t3rwin/2-channel-EEG/KiCad/2-channel-EEG.kicad_pcb

## KiCad design KiCad/2-channel-EEG.kicad_pcb (2024-04-19)

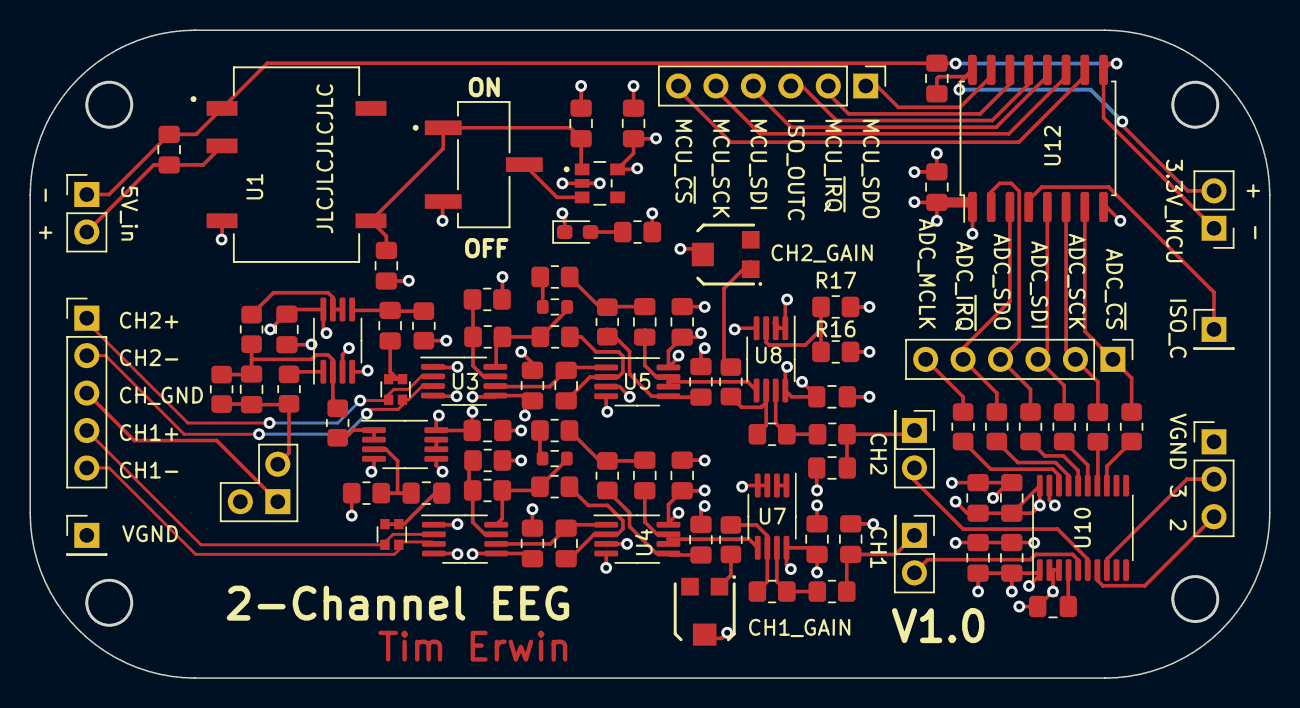
[picture p1: board 2-channel-EEG.kicad_pcb from above]

Board: 4 copper layers, 84.1 x 43.9 mm, 92 parts (0 on the bottom side), 74 nets.

Parts:
C1: 4.7u; C_0805_2012Metric_Pad1.18x1.45mm_HandSolder
C2, C3, C7, C8, C9, C10, C11, C15, C18, C21, C23, C24, C26, C27, C30: 0.1u; C_0805_2012Metric_Pad1.18x1.45mm_HandSolder
C4, C5, C6, C16, C17, C19, C20, C25: 10u; C_0805_2012Metric_Pad1.18x1.45mm_HandSolder
C12, C28, C29: 1u; C_0805_2012Metric_Pad1.18x1.45mm_HandSolder
C13, C14: 47n; C_0805_2012Metric_Pad1.18x1.45mm_HandSolder
C22: 1n; C_0805_2012Metric_Pad1.18x1.45mm_HandSolder
D1: LED_0603_1608Metric_Pad1.05x0.95mm_HandSolder
J1: Power_Input; PinHeader_1x02_P2.54mm_Vertical
J2: Nucleo_3.3; PinHeader_1x02_P2.54mm_Vertical
J3: Electrode_Input; PinHeader_1x05_P2.54mm_Vertical
J4: GND_select; PinHeader_2x02_P2.54mm_Vertical
J5, J6: Conn_02x01; PinHeader_2x01_P2.54mm_Vertical
J7: VGND; PinHeader_1x01_P2.54mm_Vertical
J8: Conn_01x03; PinHeader_1x03_P2.54mm_Vertical
J9: ADC_Data; PinHeader_1x06_P2.54mm_Vertical
J10: ISO_IN_C; PinHeader_1x01_P2.54mm_Vertical
J11: MCU_Data; PinHeader_1x06_P2.54mm_Vertical
JP1, JP2: SolderJumper_2_Open; R_0603_1608Metric
R1, R3, R21, R30, R31: 1M; R_0805_2012Metric_Pad1.20x1.40mm_HandSolder
R2, R4: 1K; R_0805_2012Metric_Pad1.20x1.40mm_HandSolder
R5, R6: 3M; R_0805_2012Metric_Pad1.20x1.40mm_HandSolder
R7, R8, R9, R10: 56.2k; R_0805_2012Metric_Pad1.20x1.40mm_HandSolder
R11: 510; R_0805_2012Metric_Pad1.20x1.40mm_HandSolder
R12, R13: 1k; R_0805_2012Metric_Pad1.20x1.40mm_HandSolder
R14, R15: 100k; R_0805_2012Metric_Pad1.20x1.40mm_HandSolder
R16, R17, R22, R23: 10k; R_0805_2012Metric_Pad1.20x1.40mm_HandSolder
R18, R19: 100; R_0805_2012Metric_Pad1.20x1.40mm_HandSolder
R20: 0; R_0805_2012Metric_Pad1.20x1.40mm_HandSolder
R24, R25, R26, R27, R28, R29: 10; R_0805_2012Metric_Pad1.20x1.40mm_HandSolder
RN1, RN2: Matched_10K_Resistor_Array_2x; R_Array_Matched_2x0606
RV1, RV2: 10k; TRIM_35WR10KLFTR
SW1: SW_Push_SPDT; SW_JS102011SCQN
U1: PESE1-S5-S5-M-TR; CONV_PESE1-S5-S5-M
U2, U3: AD8237; MSOP-8_3x3mm_P0.65mm
U4, U5, U7, U8, U9, U11: AD8606; MSOP-8_3x3mm_P0.65mm
U6: TCR2EF33; IC_TC4S584F_LF
U10: MCP3562R; TSSOP-20_4.4x6.5mm_P0.65mm
U12: ISO6763-Q1; SOIC-16W_7.5x10.3mm_P1.27mm

Connections:
+3.3V: C2.2, C3.2, C7.2, C8.2, C12.2, C15.1, C18.1, C20.2, C21.2, C23.2, C24.2, C25.2, C26.2, C27.1, R11.2, R16.2, U2.5 (V+), U3.5 (V+), U4.8 (V+), U5.8 (V+), U6.5 (VOUT), U7.8 (V+), U8.8 (V+), U9.8 (V+), U10.1 (AVDD), U10.20 (DVDD), U11.8 (V+), U12.1 (VCC1)
+3V3_nucleo: C30.1, J2.1, U12.16 (VCC2)
+5V: C1.2, J1.1, U1.2 (+VIN)
+5V_iso: C4.2, C9.2, SW1.1 (A), U1.5 (+VOUT), U6.1 (VIN)
/ADC0: J5.2, U10.5 (CH0)
/ADC1: J6.2, U10.6 (CH1)
/ADC2: J8.3, U10.7 (CH2)
/ADC3: J8.2, U10.8 (CH3)
/ADC_MCLK: J9.6, R24.1
/ADC_SCK: J9.2, R28.1, U12.6 (OUTE)
/ADC_SDI: J9.3, R27.1, U12.5 (OUTD)
/ADC_SDO: J9.4, R26.1, U12.2 (INA)
/ADC_~CS: J9.1, R29.1, U12.7 (OUTF)
/ADC_~IRQ: J9.5, R25.1, U12.3 (INB)
/CH1+: J3.4, RN2.3, U2.2 (+)
/CH1-: J3.5, RN2.4, U2.3 (-)
/CH1_AO: C16.2, J5.1, R18.1
/CH2+: J3.1, RN1.3, U3.2 (+)
/CH2-: J3.2, RN1.4, U3.3 (-)
/CH2_AO: C17.2, J6.1, R19.1
/CH_GND: J3.3, J4.1
/Driven_GND: C22.1, J4.2, R20.1, R21.1
/ISO_INC: J10.1, U12.4 (INC)
/ISO_OUTC: J11.3, U12.13 (OUTC)
/LDO_CTRL: SW1.2 (B), U6.3 (CTRL)
/MCU_SCK: J11.5, U12.11 (INE)
/MCU_SDI: J11.4, U12.12 (IND)
/MCU_SDO: J11.1, U12.15 (OUTA)
/MCU_~CS: J11.6, U12.10 (INF)
/MCU_~IRQ: J11.2, U12.14 (OUTB)
/VGND: C13.1, C14.1, C16.1, C17.1, J4.3 (Pin_4), J7.1, J8.1, R2.2, R4.2, R30.1, R31.1, RV1.2, RV2.2, U4.3 (+), U5.3 (+), U8.1, U8.2 (-), U9.3 (+)
GND: C2.1, C3.1, C4.1, C7.1, C8.1, C9.1, C12.1, C15.2, C18.2, C19.2, C20.1, C21.1, C23.1, C24.1, C25.1, C26.1, C27.2, D1.1 (K), R17.1, SW1.3 (C), U1.4 (0V), U2.1 (BW), U2.4 (V-), U3.1 (BW), U3.4 (V-), U4.4 (V-), U5.4 (V-), U6.2 (GND), U7.3 (+), U7.4 (V-), U8.4 (V-), U9.4 (V-), U10.2 (AGND), U10.3 (REFIN-), U10.19 (DGND), U11.4 (V-), U11.5 (+), U12.8 (GND1)
GND1: C1.1, C30.2, J1.2, J2.2, U1.1 (GND), U12.9 (GND2)
unnamed: C10.1, R7.1, R9.2
unnamed: C11.1, R8.1, R10.2
unnamed: C28.2, RN1.1, RN1.2
unnamed: C29.2, RN2.1, RN2.2
unnamed: D1.2 (A), R11.1
unnamed: JP1.1 (A), R1.1, R5.2, U2.8
unnamed: JP1.2 (B), R7.2
unnamed: JP2.1 (A), R3.1, R6.2, U3.8
unnamed: JP2.2 (B), R8.2
unnamed: R12.1, RV1.1
unnamed: R13.1, RV2.1
unnamed: R14.2, R18.2, U7.7
unnamed: R15.2, R19.2, U8.7
unnamed: R20.2, U9.1
unnamed: R1.2, R2.1, U2.7 (FB)
unnamed: C5.1, U2.6 (VREF), U4.1
unnamed: R3.2, R4.1, U3.7 (FB)
unnamed: C6.1, U3.6 (VREF), U5.1
unnamed: C5.2, R5.1, U4.2 (-)
unnamed: C13.2, R9.1, U4.5 (+)
unnamed: C10.2, U4.6 (-), U4.7, U7.5 (+)
unnamed: C6.2, R6.1, U5.2 (-)
unnamed: C14.2, R10.1, U5.5 (+)
unnamed: C11.2, U5.6 (-), U5.7, U8.5 (+)
unnamed: U7.1, U7.2 (-)
unnamed: R12.2, R14.1, U7.6 (-)
unnamed: R16.1, R17.2, U8.3 (+)
unnamed: R13.2, R15.1, U8.6 (-)
unnamed: C22.2, R21.2, R22.2, R23.1, U9.2 (-)
unnamed: C28.1, R30.2, U9.5 (+)
unnamed: R22.1, U9.6 (-), U9.7
unnamed: R24.2, U10.18 (MCLK)
unnamed: C19.1, U10.4 (REFIN+/OUT)
unnamed: R28.2, U10.14 (SCK)
unnamed: R27.2, U10.15 (SDI)
unnamed: R26.2, U10.16 (SDO)
unnamed: R29.2, U10.13 (~CS)
unnamed: R25.2, U10.17 (~IRQ/MDAT)
unnamed: C29.1, R31.2, U11.3 (+)
unnamed: R23.2, U11.1, U11.2 (-)
unnamed: U11.6 (-), U11.7
