t3rwin/2-channel-EEG/py/Arduino_Com.py

import serial.tools.list_ports

ports = serial.tools.list_ports.comports()
serialInst = serial.Serial()

portsList = []

for onePort in ports:
    portsList.append(str(onePort))
    print(str(onePort))

val = input("Select Port: COM")

for x in range(0,len(portsList)):
    if portsList[x].startswith("COM" + str(val)):
        portVar = "COM" + str(val)
        print(portVar)

serialInst.baudrate = 11600
serialInst.port = portVar
serialInst.open()

while True:
	if serialInst.in_waiting:
		packet = serialInst.readline()
		print(packet.decode('utf').rstrip('\n'))
