t3rwin/2-channel-EEG/(commit log)

2024-01-16 Schematic Updates
    isolation converter, 3.3V LDO, Channel1, Driven GND, Rail Splitter
    [2-channel-EEG.kicad_sch]
2024-01-18 separated kicad files from python files
    [2-channel-EEG.kicad_pcb, 2-channel-EEG.kicad_sch]
2024-02-05 fixed power connections on U3A, added output filter
    [2-channel-EEG.kicad_sch]
2024-04-02 add 2nd channel, start pcb
    [2-channel-EEG.kicad_pcb, 2-channel-EEG.kicad_sch]
2024-04-03 PCB updates
    [2-channel-EEG.kicad_pcb]
2024-04-04 drl filter, additional caps for adc, Rs for adc spi.
    [2-channel-EEG.kicad_pcb, 2-channel-EEG.kicad_sch]
2024-04-05 updated DRL and pcb
    [2-channel-EEG.kicad_pcb, 2-channel-EEG.kicad_sch]
2024-04-08 added solder jumpers between INA and filter
    [2-channel-EEG.kicad_pcb, 2-channel-EEG.kicad_sch]
2024-04-09 fix wrong reference C,R values
    [2-channel-EEG.kicad_pcb, 2-channel-EEG.kicad_sch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]
2024-04-10 schematic BOM
    [2-channel-EEG.csv, 2-channel-EEG.kicad_pcb, 2-channel-EEG.kicad_sch, BOM_2-channel-EEG.csv]
2024-04-12 final edits before ordering PCB
    [2-channel-EEG-B_Cu.gbl, 2-channel-EEG-B_Mask.gbs, 2-channel-EEG-B_Paste.gbp, 2-channel-EEG-B_Silkscreen.gbo, 2-channel-EEG-Edge_Cuts.gm1, 2-channel-EEG-F_Cu.gtl, 2-channel-EEG-F_Mask.gts, 2-channel-EEG-F_Paste.gtp]
2024-04-15 py live processing
    live filtering and plotting of pre recorded data
2024-04-17 Create UART
2024-04-17 live processing update
    [power.csv]
2024-04-17 Main and it's prototypes
2024-04-19 fixed missaligned input labels :(
    [2-channel-EEG.kicad_pcb]
2024-04-23 File contains code that is sent via uart
    receiving the data with minimal processing
2024-04-25 upsampling and interpolation of power values
2024-04-25 edit .gitignore
    [BOM_2-channel-EEG copy.csv]
2024-05-06 one channel live
    [power.csv]
2024-05-15 remove kicad backups
