t3rwin/2-channel-EEG/(notices)

Notices in the files:
C/UART/main.c:
Copyright (c) 2024 STMicroelectronics.
All rights reserved.
This software is licensed under terms that can be found in the LICENSE file
